UniversalScientificTechnologies/GEODOS02/(list of files, cad)

Other CAD files:
cad/configuration.scad
cad/src/BoxHolder.scad
