UniversalScientificTechnologies/GEODOS02/(commit log)

2023-02-18 Initial commit of GEODOS02 design based on design of "GEODOS01" placed on Lomnicky Stit.
    [BoxHolder.scad, configuration.scad]
2023-02-18 attempt to fix narrowing conversion of '181' from 'int' to 'char' inside { }
    [GEODOS_1024_LS.ino]
2023-02-19 get rid off SD card if not inserted after power on
2023-02-19 double LED bling if SD card is inserted
2023-02-19 double LED bling if SD card is inserted, extended build
